AlexNayl/AutomaticWindowFan/External Resources/120mm_fan_asm.stp

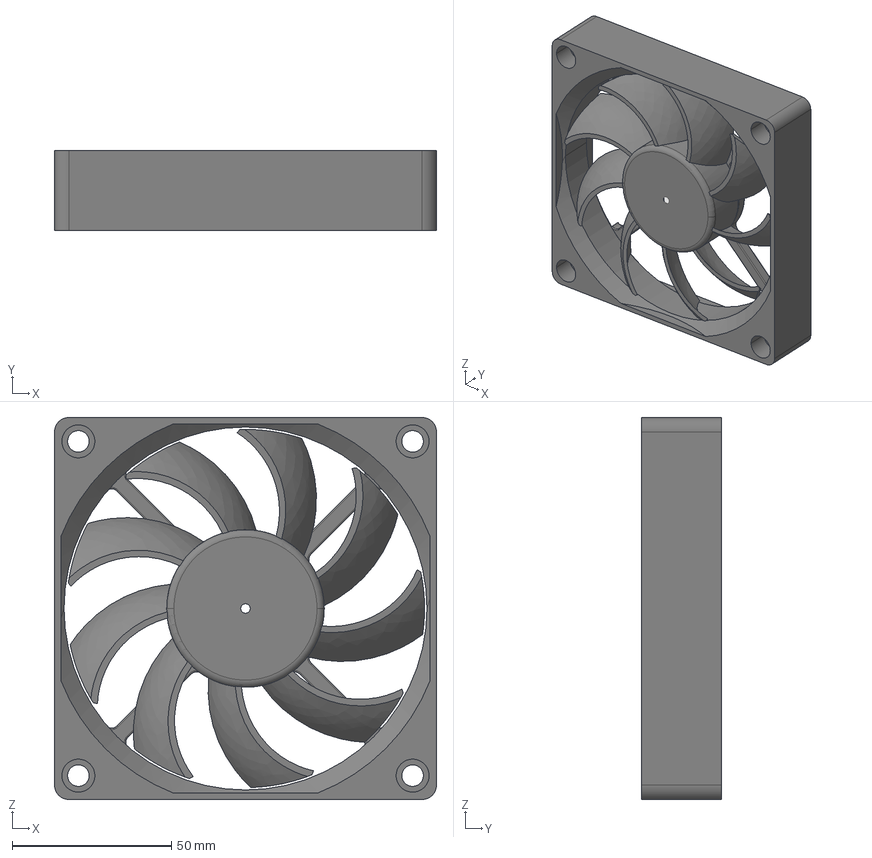
[picture p4: CAD file, 2025-11-21]
External Resources/120mm_fan_asm.stp
120.0 x 25.0 x 120.0 mm
120MM_FAN_CASE
120MM_FAN
