AlexNayl/AutomaticWindowFan/(commit log)

2025-11-21 import preexsisting files
    [120mm_fan_asm.stp]
2025-11-23 setup platformIO and created simple blink script with default arduino drivers
2025-11-23 wrote out the aurduino drivers, now using the microcontroller manufacturers definitions in avr/io.h
2025-11-25 added power and connection diagrams to hardware blog
2025-11-30 implemented UART / Serial output for debugging
2025-12-20 setup reset before system time overflow to prevent shenanigans
    [SystemTime.c, main.c]
2026-01-08 implemented button state and debounce
2026-01-26 implemented rotary encoder logic
